dakshhpanchal/embedded/assets/3D Models/XT30PW-M.step

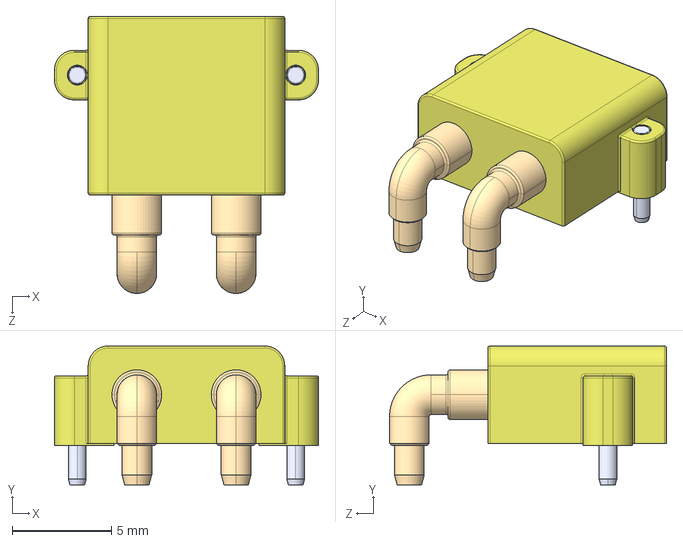
[picture p2: CAD file, 2026-07-12]
assets/3D Models/XT30PW-M.step
13.3 x 7.00 x 14.0 mm
