dakshhpanchal/embedded/assets/3D Models/XT90PW-M.STEP

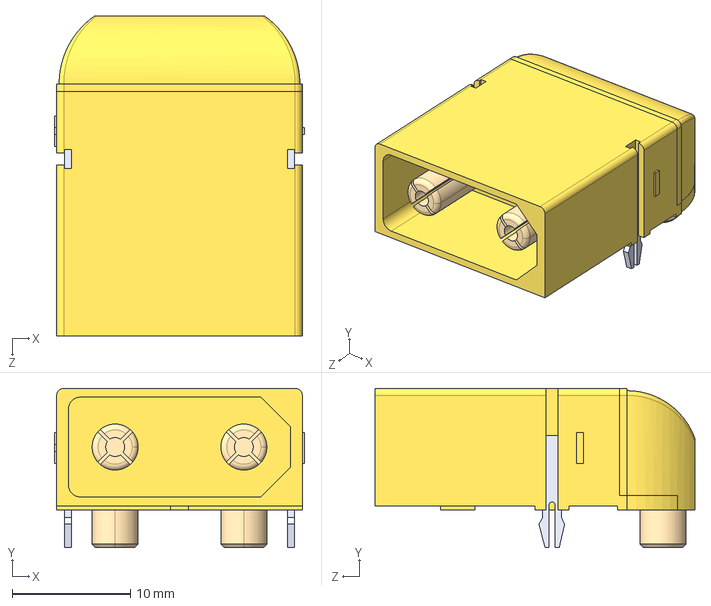
[picture p3: CAD file, 2026-05-20]
assets/3D Models/XT90PW-M.STEP
21.2 x 13.5 x 27.1 mm
