dakshhpanchal/embedded/assets/3D Models/LMR33630ADDAR.step

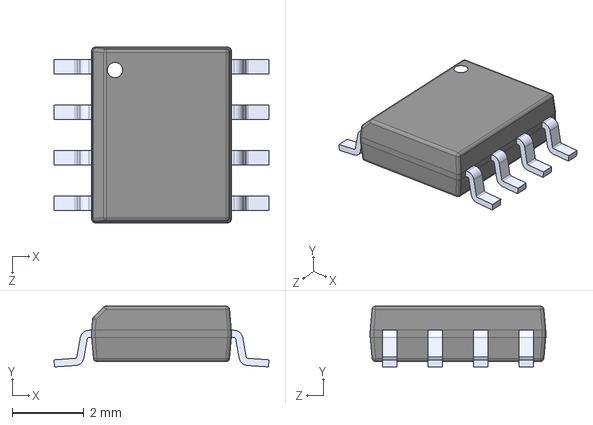
[picture p4: CAD file, 2026-05-20]
assets/3D Models/LMR33630ADDAR.step
6.00 x 1.70 x 4.90 mm
