dakshhpanchal/embedded/assets/PCB Files/UGV.kicad_pcb

## KiCad design assets/PCB Files/UGV.kicad_pcb (2026-07-12)

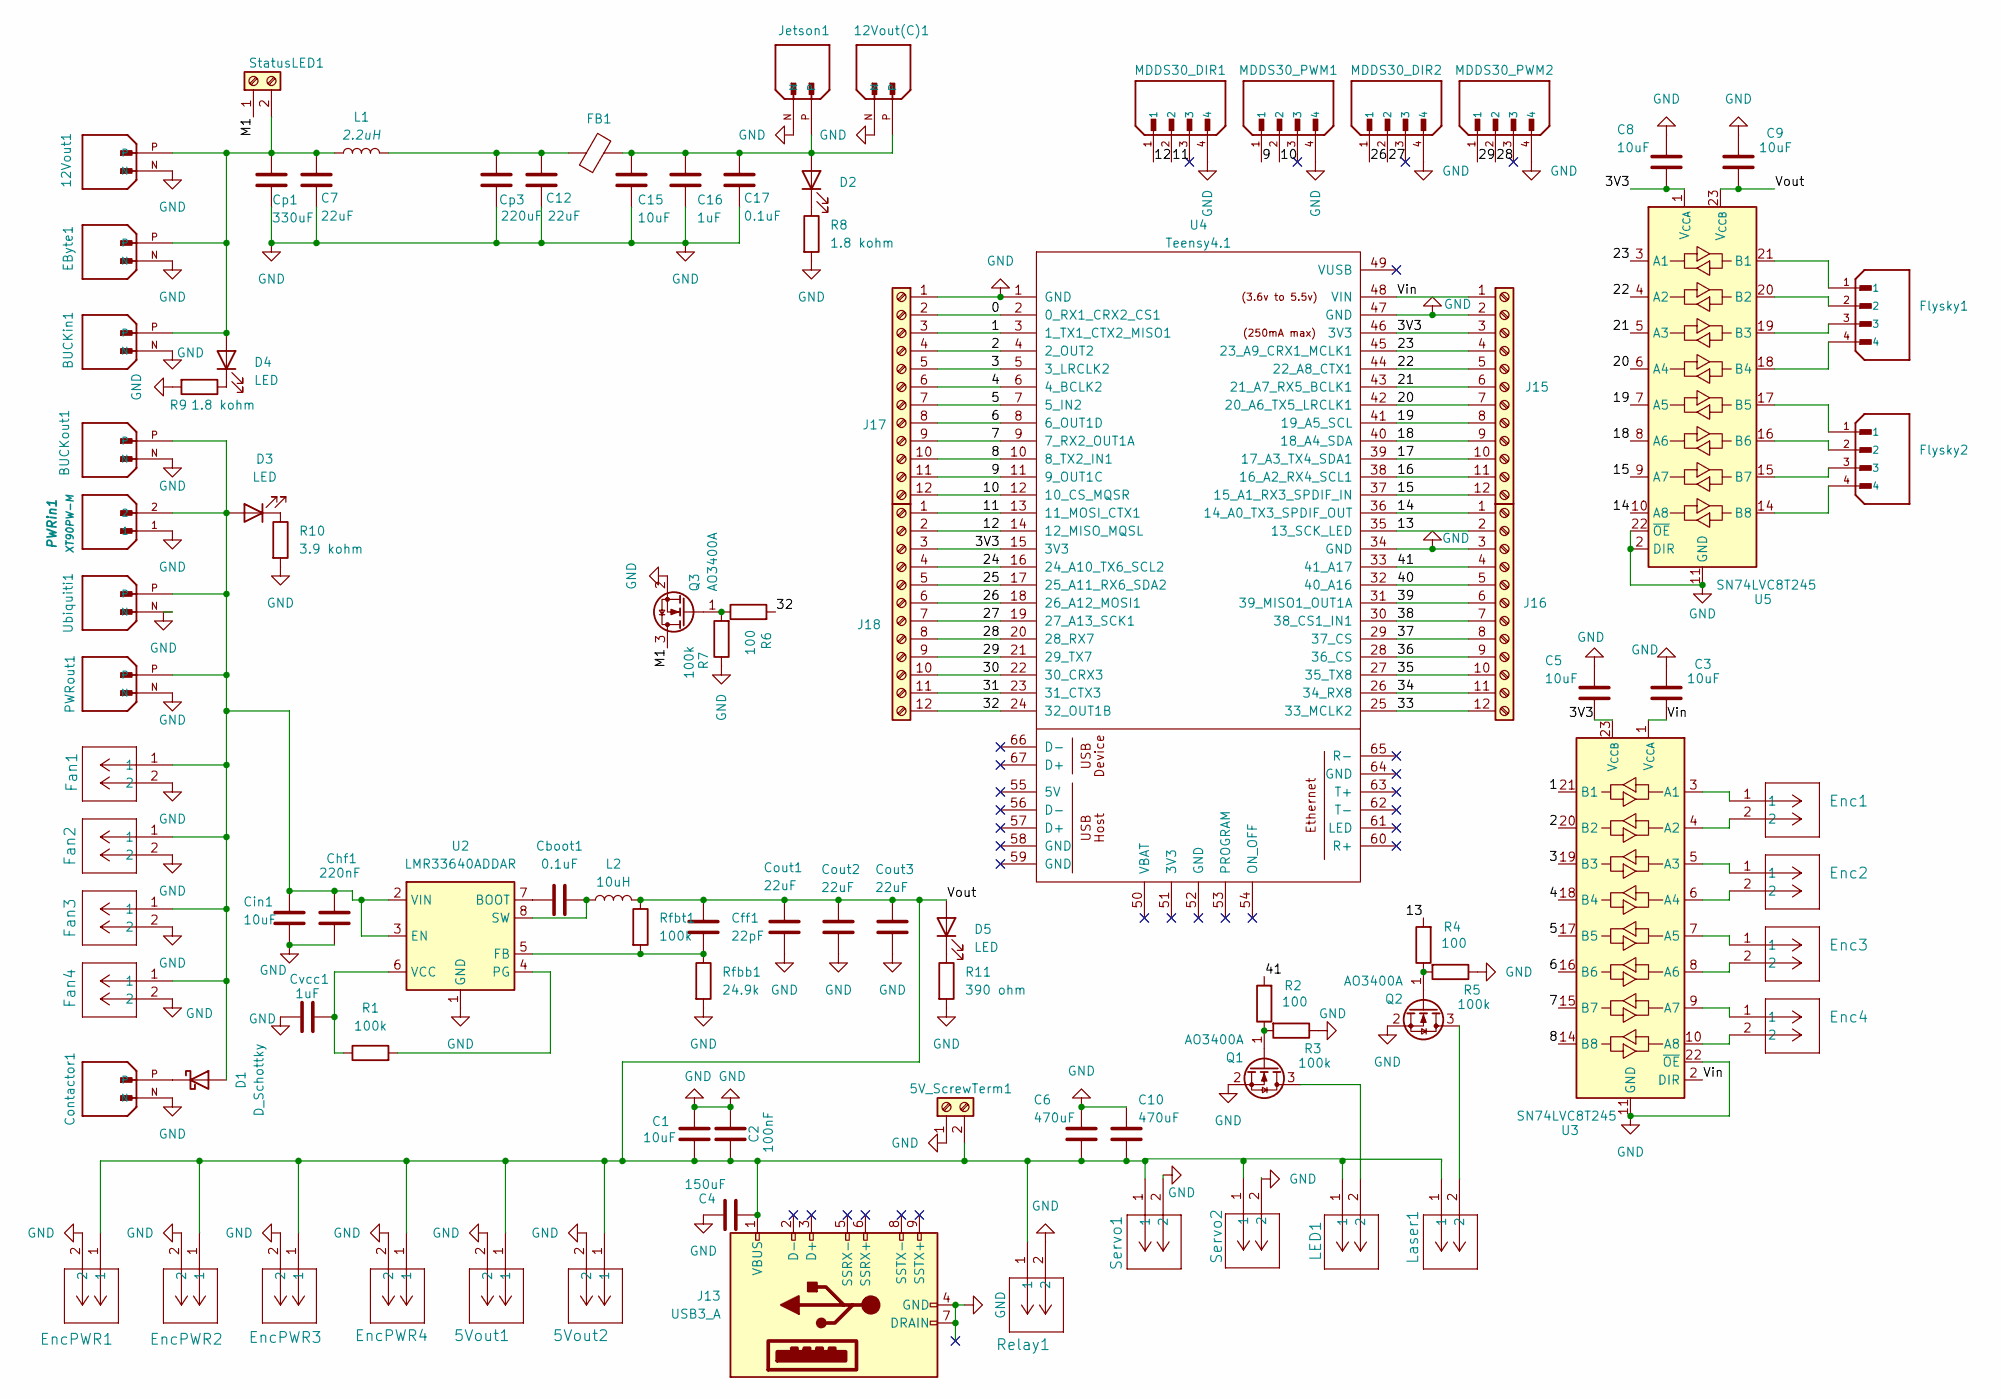
[picture p5: schematic UGV.kicad_sch]

Parts:
5V_ScrewTerm1: Screw_Terminal_01x02; TerminalBlock_Phoenix_MKDS-1,5-2-5.08_1x02_P5.08mm_Horizont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
5Vout1, 5Vout2: B2B-XH-A; JST_XH_B2B-XH-A_1x02_P2.50mm_Vertical
12Vout1, 12Vout(C)1: XT30PW-M; AMASS_XT30PW-M; PARTREV 1.2
BUCKin1: XT30PW-M; AMASS_XT30PW-M; PARTREV 1.2
BUCKout1: XT30PW-M; AMASS_XT30PW-M; PARTREV 1.2
C1, C3, C5, C8, C9, C15: 10uF; C_1210_3225Metric_Pad1.33x2.70mm_HandSolder
C2: 100nF; C_1206_3216Metric_Pad1.33x1.80mm_HandSolder
C4: 150uF; CP_Elec_8x10.5
C6, C10: 470uF; CP_Radial_D8.0mm_P3.50mm
C7, C12: 22uF; C_1210_3225Metric_Pad1.33x2.70mm_HandSolder
C16: 1uF; C_1206_3216Metric_Pad1.33x1.80mm_HandSolder
C17: 0.1uF; C_1206_3216Metric_Pad1.33x1.80mm_HandSolder
Cboot1: 0.1uF; C_1206_3216Metric_Pad1.33x1.80mm_HandSolder
Cff1: 22pF; C_0805_2012Metric_Pad1.18x1.45mm_HandSolder
Chf1: 220nF; C_1206_3216Metric_Pad1.33x1.80mm_HandSolder
Cin1: 10uF; C_1210_3225Metric_Pad1.33x2.70mm_HandSolder
Contactor1: XT30PW-M; AMASS_XT30PW-M; PARTREV 1.2
Cout1, Cout2, Cout3: 22uF; C_1210_3225Metric_Pad1.33x2.70mm_HandSolder
Cp1: 330uF; CP_Radial_D10.0mm_P5.00mm
Cp3: 220uF; CP_Elec_10x10
Cvcc1: 1uF; C_1206_3216Metric_Pad1.33x1.80mm_HandSolder
D1: D_Schottky; D_SMC_Handsoldering
D2, D3, D4, D5: LED; LED_1206_3216Metric_Pad1.42x1.75mm_HandSolder
EByte1: XT30PW-M; AMASS_XT30PW-M; PARTREV 1.2
Enc1, Enc2, Enc3, Enc4: B2B-XH-A-BK; JST_XH_B2B-XH-A_1x02_P2.50mm_Vertical
EncPWR1, EncPWR2, EncPWR3, EncPWR4: B2B-XH-A; JST_XH_B2B-XH-A_1x02_P2.50mm_Vertical
FB1: 1k@1k; L_0805_2012Metric_Pad1.05x1.20mm_HandSolder
Fan1, Fan2, Fan3, Fan4: B2B-XH-A-R; JST_XH_B2B-XH-A_1x02_P2.50mm_Vertical
Flysky1, Flysky2: B4B-XH-A_LF__SN_; JST_XH_B4B-XH-A_1x04_P2.50mm_Vertical; PARTREV 7/4/21
J13: USB3_A; USB-3.0-TH_U233-091N-4BLPC17-11
J15, J16, J17, J18: Screw_Terminal_01x12; TerminalBlock_Phoenix_MPT-0,5-12-2.54_1x12_P2.54mm_Horizont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
Jetson1: XT30PW-M; AMASS_XT30PW-M; PARTREV 1.2
L1: 2.2uH; L_Vishay_IHLP-2525
L2: 10uH; SRR1280-101M
LED1: B2B-XH-A; JST_XH_B2B-XH-A_1x02_P2.50mm_Vertical
Laser1: B2B-XH-A; JST_XH_B2B-XH-A_1x02_P2.50mm_Vertical
MDDS30_DIR1, MDDS30_DIR2, MDDS30_PWM1, MDDS30_PWM2: B4B-XH-A_LF__SN_; JST_XH_B4B-XH-A_1x04_P2.50mm_Vertical; PARTREV 7/4/21
PWRin1: XT90PW-M; AMASS_XT90PW-M_1x02_P10.90mm_Horizontal; PARTREV 1.2
PWRout1: XT30PW-M; AMASS_XT30PW-M; PARTREV 1.2
Q1, Q2, Q3: AO3400A; SOT-23_Handsoldering
R1, R3, R5, R7: 100k; R_1206_3216Metric_Pad1.30x1.75mm_HandSolder
R2, R4, R6: 100; R_0805_2012Metric_Pad1.20x1.40mm_HandSolder
R8, R9: 1.8 kohm; R_1206_3216Metric_Pad1.30x1.75mm_HandSolder
R10: 3.9 kohm; R_1206_3216Metric_Pad1.30x1.75mm_HandSolder
R11: 390 ohm; R_1206_3216Metric_Pad1.30x1.75mm_HandSolder
Relay1: B2B-XH-A; JST_XH_B2B-XH-A_1x02_P2.50mm_Vertical
Rfbb1: 24.9k; R_1206_3216Metric_Pad1.30x1.75mm_HandSolder
Rfbt1: 100k; R_1206_3216Metric_Pad1.30x1.75mm_HandSolder
Servo1, Servo2: B2B-XH-A; JST_XH_B2B-XH-A_1x02_P2.50mm_Vertical
StatusLED1: Screw_Terminal_01x02; TerminalBlock_Phoenix_MKDS-1,5-2-5.08_1x02_P5.08mm_Horizont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
U2: LMR33640ADDAR; LMR33630ADDAR; MPN LMR33630ADDAR
U3, U5: SN74LVC8T245; SOIC-24W_7.5x15.4mm_P1.27mm
U4: Teensy4.1; Teensy41
Ubiquiti1: XT30PW-M; AMASS_XT30PW-M; PARTREV 1.2

Connections:
/0: J17.2, U4.2 (0_RX1_CRX2_CS1)
/1: J17.3, U3.21 (B1), U4.3 (1_TX1_CTX2_MISO1)
/2: J17.4, U3.20 (B2), U4.4 (2_OUT2)
/3: J17.5, U3.19 (B3), U4.5 (3_LRCLK2)
/3V3: C5.2, C8.2, J15.3, J18.3, U3.23 (V_{CCB}), U3.24 (V_{CCB}), U4.15 (3V3), U4.46 (3V3), U5.1 (V_{CCA})
/4: J17.6, U3.18 (B4), U4.6 (4_BCLK2)
/5: J17.7, U3.17 (B5), U4.7 (5_IN2)
/6: J17.8, U3.16 (B6), U4.8 (6_OUT1D)
/7: J17.9, U3.15 (B7), U4.9 (7_RX2_OUT1A)
/8: J17.10, U3.14 (B8), U4.10 (8_TX2_IN1)
/9: J17.11, MDDS30_PWM1.1, U4.11 (9_OUT1C)
/10: J17.12, MDDS30_PWM1.2, U4.12 (10_CS_MQSR)
/11: J18.1, MDDS30_DIR1.2, U4.13 (11_MOSI_CTX1)
/12: J18.2, MDDS30_DIR1.1, U4.14 (12_MISO_MQSL)
/13: J16.2, R4.2, U4.35 (13_SCK_LED)
/14: J16.1, U4.36 (14_A0_TX3_SPDIF_OUT), U5.10 (A8)
/15: J15.12, U4.37 (15_A1_RX3_SPDIF_IN), U5.9 (A7)
/16: J15.11, U4.38 (16_A2_RX4_SCL1)
/17: J15.10, U4.39 (17_A3_TX4_SDA1)
/18: J15.9, U4.40 (18_A4_SDA), U5.8 (A6)
/19: J15.8, U4.41 (19_A5_SCL), U5.7 (A5)
/20: J15.7, U4.42 (20_A6_TX5_LRCLK1), U5.6 (A4)
/21: J15.6, U4.43 (21_A7_RX5_BCLK1), U5.5 (A3)
/22: J15.5, U4.44 (22_A8_CTX1), U5.4 (A2)
/23: J15.4, U4.45 (23_A9_CRX1_MCLK1), U5.3 (A1)
/24: J18.4, U4.16 (24_A10_TX6_SCL2)
/25: J18.5, U4.17 (25_A11_RX6_SDA2)
/26: J18.6, MDDS30_DIR2.1, U4.18 (26_A12_MOSI1)
/27: J18.7, MDDS30_DIR2.2, U4.19 (27_A13_SCK1)
/28: J18.8, MDDS30_PWM2.2, U4.20 (28_RX7)
/29: J18.9, MDDS30_PWM2.1, U4.21 (29_TX7)
/30: J18.10, U4.22 (30_CRX3)
/31: J18.11, U4.23 (31_CTX3)
/32: J18.12, R6.2, U4.24 (32_OUT1B)
/33: J16.12, U4.25 (33_MCLK2)
/34: J16.11, U4.26 (34_RX8)
/35: J16.10, U4.27 (35_TX8)
/36: J16.9, U4.28 (36_CS)
/37: J16.8, U4.29 (37_CS)
/38: J16.7, U4.30 (38_CS1_IN1)
/39: J16.6, U4.31 (39_MISO1_OUT1A)
/40: J16.5, U4.32 (40_A16)
/41: J16.4, R2.2, U4.33 (41_A17)
/M1: Q3.3 (D), StatusLED1.1
/Vin: C3.2, J15.1, U3.1 (V_{CCA}), U3.2 (DIR), U4.48 (VIN)
/Vout: 5V_ScrewTerm1.2, 5Vout1.1, 5Vout2.1, C1.2, C2.1, C4.1, C6.2, C9.2, C10.2, Cff1.1, Cout1.1, Cout2.1, Cout3.1, D5.2 (A), EncPWR1.1, EncPWR2.1, EncPWR3.1, EncPWR4.1, J13.1 (VBUS), L2.2, LED1.1, Laser1.1, Relay1.1, Rfbt1.1, Servo1.1, Servo2.1, U5.23 (V_{CCB}), U5.24 (V_{CCB})
GND: 5V_ScrewTerm1.1, 5Vout1.2, 5Vout2.2, 12Vout1.N, 12Vout(C)1.N, BUCKin1.N, BUCKout1.N, C1.1, C2.2, C3.1, C4.2, C5.1, C6.1, C7.2, C8.1, C9.1, C10.1, C12.2, C15.2, C16.2, C17.2, Chf1.2, Cin1.2, Contactor1.N, Cout1.2, Cout2.2, Cout3.2, Cp1.2, Cp3.2, Cvcc1.2, EByte1.N, EncPWR1.2, EncPWR2.2, EncPWR3.2, EncPWR4.2, Fan1.2, Fan2.2, Fan3.2, Fan4.2, J13.4 (GND), J13.7 (DRAIN), J15.2, J16.3, J17.1, Jetson1.N, MDDS30_DIR1.4, MDDS30_DIR2.4, MDDS30_PWM1.4, MDDS30_PWM2.4, PWRin1.1, PWRout1.N, Q1.2 (S), Q2.2 (S), Q3.2 (S), R3.1, R5.1, R7.1, R8.2, R9.2, R10.2, R11.2, Relay1.2, Rfbb1.2, Servo1.2, Servo2.2, U2.1 (GND), U2.9 (GND), U3.11 (GND), U3.12 (GND), U3.13 (GND), U3.22 (~OE), U4.1 (GND), U4.34 (GND), U4.47 (GND), U5.2 (DIR), U5.11 (GND), U5.12 (GND), U5.13 (GND), U5.22 (~OE), Ubiquiti1.N
unnamed: C12.1, Cp3.1, FB1.1, L1.2
unnamed: BUCKout1.P, Chf1.1, Cin1.1, D1.2 (A), D3.2 (A), Fan1.1, Fan2.1, Fan3.1, Fan4.1, PWRin1.2, PWRout1.P, U2.2 (VIN), U2.3 (EN), Ubiquiti1.P
unnamed: Contactor1.P, D1.1 (K)
unnamed: 12Vout(C)1.P, C15.1, C16.1, C17.1, D2.2 (A), FB1.2, Jetson1.P
unnamed: D2.1 (K), R8.1
unnamed: D3.1 (K), R10.1
unnamed: 12Vout1.P, BUCKin1.P, C7.1, Cp1.1, D4.2 (A), EByte1.P, L1.1, StatusLED1.2
unnamed: D4.1 (K), R9.1
unnamed: D5.1 (K), R11.1
unnamed: LED1.2, Q1.3 (D)
unnamed: Q1.1 (G), R2.1, R3.2
unnamed: Laser1.2, Q2.3 (D)
unnamed: Q2.1 (G), R4.1, R5.2
unnamed: Q3.1 (G), R6.1, R7.2
unnamed: Cboot1.1, U2.7 (BOOT)
unnamed: Cff1.2, Rfbb1.1, Rfbt1.2, U2.5 (FB)
unnamed: R1.2, U2.4 (PG)
unnamed: Cboot1.2, L2.1, U2.8 (SW)
unnamed: Cvcc1.1, R1.1, U2.6 (VCC)
unnamed: Enc1.1, U3.3 (A1)
unnamed: Enc1.2, U3.4 (A2)
unnamed: Enc2.1, U3.5 (A3)
unnamed: Enc2.2, U3.6 (A4)
unnamed: Enc3.1, U3.7 (A5)
unnamed: Enc3.2, U3.8 (A6)
unnamed: Enc4.1, U3.9 (A7)
unnamed: Enc4.2, U3.10 (A8)
unnamed: Flysky1.1, U5.21 (B1)
unnamed: Flysky1.2, U5.20 (B2)
unnamed: Flysky1.3, U5.19 (B3)
unnamed: Flysky1.4, U5.18 (B4)
unnamed: Flysky2.1, U5.17 (B5)
unnamed: Flysky2.2, U5.16 (B6)
unnamed: Flysky2.3, U5.15 (B7)
unnamed: Flysky2.4, U5.14 (B8)

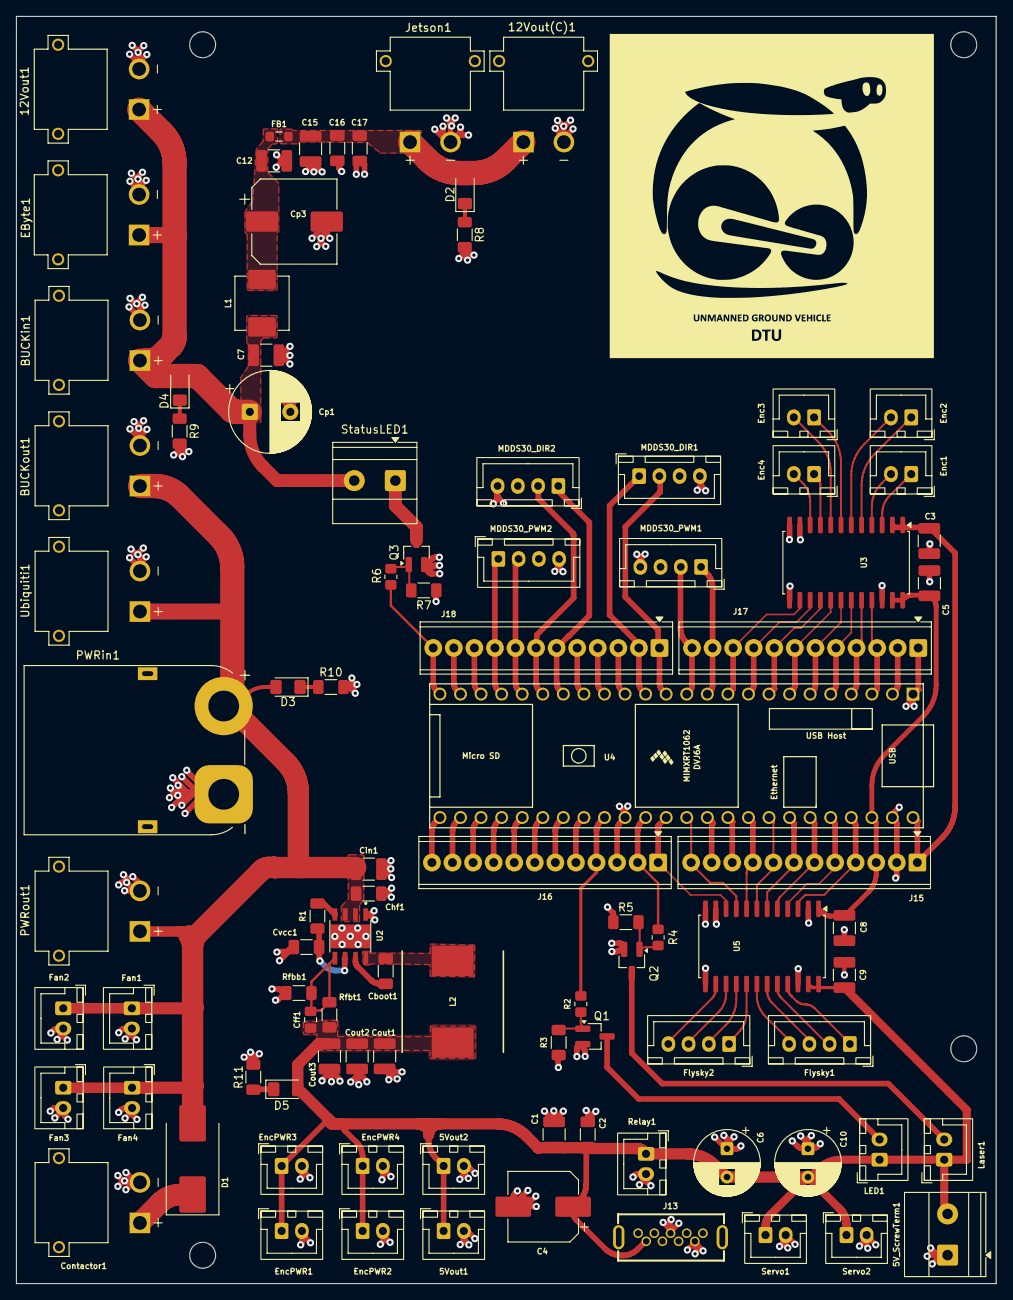
[picture p6: board UGV.kicad_pcb from above]

Board: 2 copper layers, 121.0 x 156.5 mm, 94 parts (0 on the bottom side), 82 nets.
