dakshhpanchal/embedded/(commit log)

2026-05-05 PCB Done
    [UGV.kicad_pcb, UGV.kicad_sch]
2026-05-20 Completed Routing of the PCB
    [LMR33630ADDAR.step, UGV.kicad_pcb, UGV.kicad_sch, XT90PW-M.STEP]
2026-07-12 manual and estop done
    [LMR33630ADDAR.step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]
